lostclus/FPVRobot/schematic.pdf

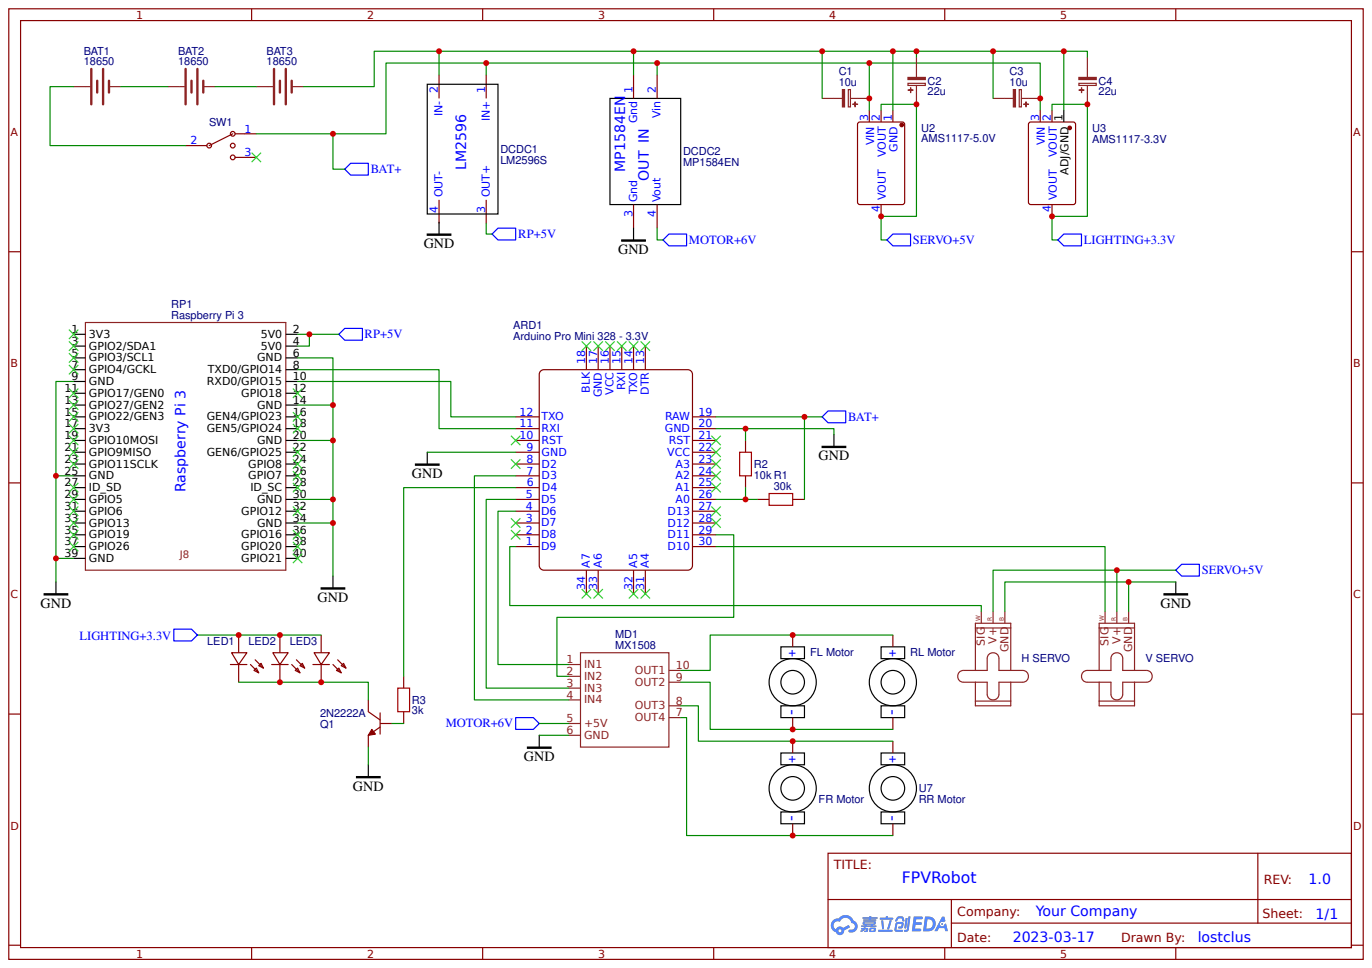
[picture p3: page 1]

GND 1 VOUT 2 VIN 3 VOUT 4

ADJ/GND 1 VOUT 2 VIN 3 VOUT 4

ARD1
Arduino Pro Mini 328 - 3.3V
D9 1 D8 2 D7 3 D6 4 D5 5 D4 6 D3 7 D2 8 GND 9 RST 10 RXI 11 TXO 12

DTR 13 TXO 14 RXI 15 VCC 16 GND 17 BLK 18
