lostclus/FPVRobot/(commit log)

2023-03-07 Add motor servo module.
2023-03-07 Add web socket.
2023-03-07 Add servo move.
2023-03-07 Add servo move in pi.
2023-03-07 Add motor control.
2023-03-09 Add voltage control.
2023-03-09 Add motor speed.
2023-03-10 Fix motor left/right.
2023-03-11 Add led matrix.
2023-03-12 Change VOLTAGE_R1. Change servo movement.
2023-03-13 Remove LED matrix.
2023-03-15 Add camera parameters. Update style.
2023-03-16 Add poweroff. Update style.
2023-03-16 Add on/off camera control.
2023-03-16 Fix motor speed when using touch screen or mouse.
2023-03-23 Resolve control conflicts between multiple parallel web sessions.
    [ard1.py, handlers.py]
